hkchengrex/motor-driver/README.md

# Motor Driver Projects.

See [Introduction](wiki/Introduction.md).

By Rex Cheng.
