hkchengrex/motor-driver/wiki/led.md

# LED signal

## Life Signal LED
LED A is the LED for life signal. In normal operation, it will toggle every 512 ms. If the encoder is determined to be malfunctioned, it will flash much rapidly (toggle every 42 ms).

## Command signal LED
LED B is the command signal LED. It will light up if a command is received in last 512 ms.
