hkchengrex/motor-driver/test.xlsx

Sheet: Sheet11
0 | 0
34 | 1118 | 1118 | 34
139 | 2236 | 1118 | 105 | 71
314 | 3354 | 1118 | 175 | 70
559 | 4472 | 1118 | 245 | 70
873 | 5590 | 1118 | 314 | 69
1257 | 6708 | 1118 | 384 | 70
1711 | 7826 | 1118 | 454 | 70
2288 | 7827 | 1 | 577 | 123
2742 | 6709 | -1118 | 454 | -123
3126 | 5591 | -1118 | 384 | -70
3441 | 4473 | -1118 | 315 | -69
3685 | 3355 | -1118 | 244 | -71
3860 | 2237 | -1118 | 175 | -69
3965 | 1119 | -1118 | 105 | -70
4000 | 0 | -1119 | 35 | -70

Sheet: Sheet10
34 | 1118
139 | 2236 | 1118
314 | 3354 | 1118
559 | 4472 | 1118
873 | 5590 | 1118
1257 | 6708 | 1118
1711 | 7826 | 1118
2236 | 8945 | 1119
2760 | 7827 | -1118
3214 | 6709 | -1118
3598 | 5591 | -1118
3913 | 4473 | -1118
4157 | 3355 | -1118
4332 | 2237 | -1118
4000 | 0 | -2237
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
