hkchengrex/motor-driver/user/at_mode.h

#ifndef _AT_MODE_H
#define _AT_MODE_H

//AT mode for using higher-level machine to command Gungnir
//ASCII protocol

//Please read the wiki for user manual.

#include "stm32f10x.h"

void at_mode_init(void);

#endif
