hkchengrex/motor-driver/user/math.h

#ifndef _MATH_H
#define _MATH_H

#include "stm32f10x.h"

typedef int64_t s64;
typedef uint32_t u64;

s32 int_sin(s32 a);
s32 int_cos(s32 a);
s16 int_tan(s16 a);

s16 int_arc_sin(s16 sin_val);
s16 int_arc_cos(s16 cos_val);
s16 int_arc_tan(s32 tan_val);
s16 int_arc_tan2(s32 y, s32 x);

#define ABS(x) ((x)<0?(-(x)):(x))
#define SQR(x) ((x)*(x))
#define SIGN(x) ((x)<0?(-1):(1))
#define CAP(a, b, c) ((a)<(b)?(b):((a)>(c)?(c):(a)))
u32 Sqrt(s64 v);

#endif
