hkchengrex/motor-driver/(commit log)

2018-01-23 fix off by one
    [encoder.c, main.c, path.c]
2018-05-03 testing code
    [test.xlsx]
2018-05-04 tested ok
    [test.xlsx]
